Tom-Chen/softsys-synth/nearly5kHz.png

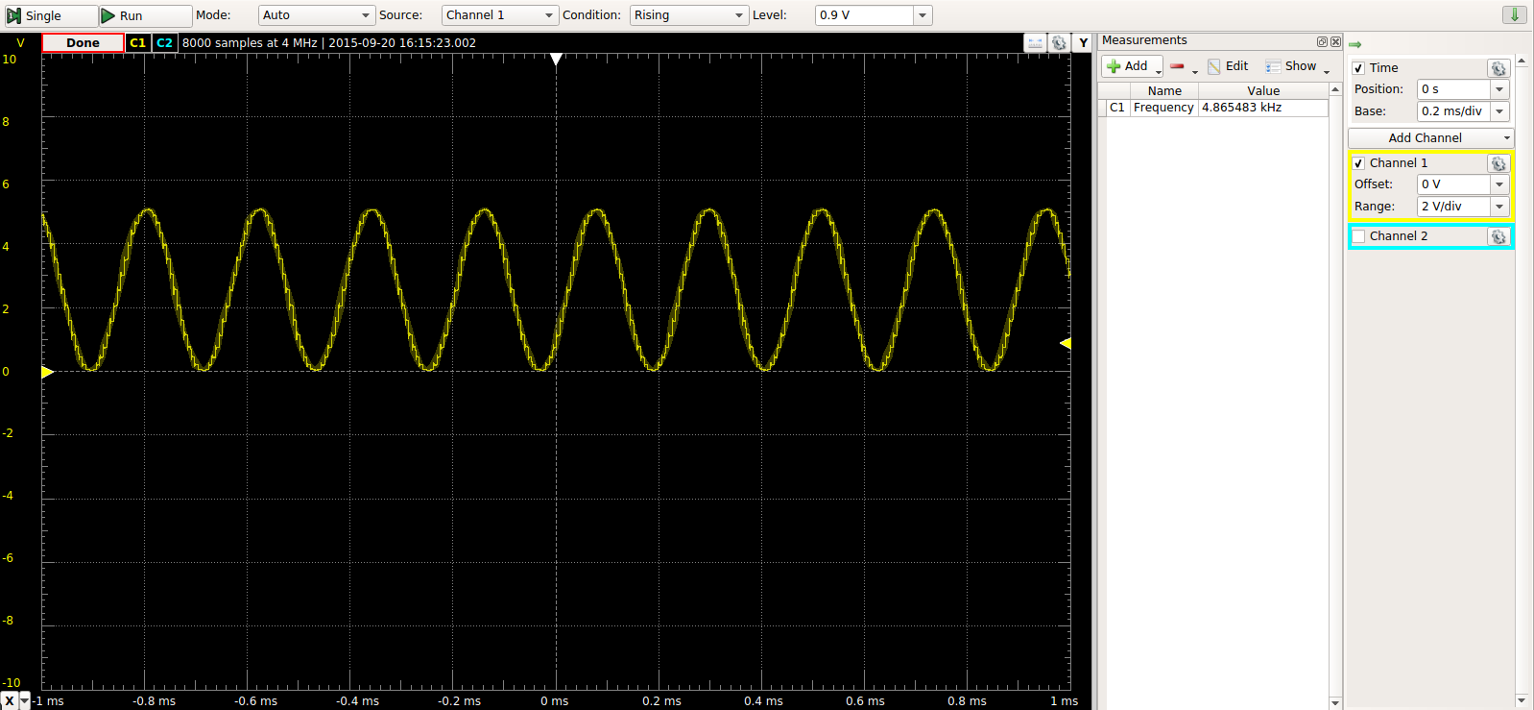
nearly5kHz.png
