Tom-Chen/softsys-synth/tl972p.png

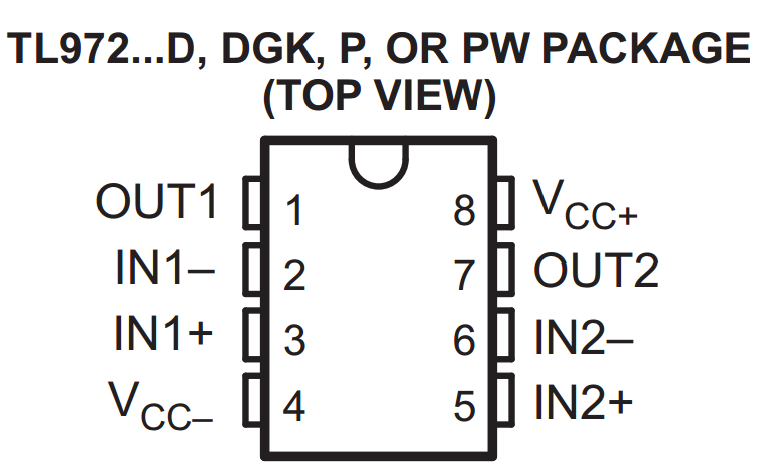
tl972p.png
