Tom-Chen/softsys-synth/(commit log)

2015-09-18 first version of interrupt handler that generates sin waves
2015-09-20 fixed writing backwards issue, hit speeds of 1.8Khz
    [singleByte.ino, testingBitWriting.ino]
2015-09-27 playNotes works! mysterious 7 hz freq
2015-09-29 Added TODO for getting play/pause button to work
2015-10-04 Used analog in for button
2015-10-04 playNotes button press to change modes now works
2015-10-06 Added schematic and tl972p data sheet
2015-10-09 changed buttonPress checker to be 100hz
2015-10-16 changed button press debouncers to use millis
